gabrielpalassi/DontForget/docs/Relatório & Documentação.pdf

Experiência – Sistema de Sonar

Escola Politécnica da USP
Departamento de Engenharia de Computação e Sistemas Digitais PCS3645 – Laboratório Digital II

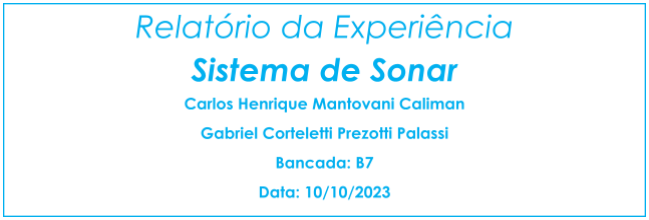
[picture p4: figure]

Turma 02 – Prof. Wilian França

### 1. Objetivos

Esta experiência tem por objetivo iniciar o desenvolvimento de um circuito que realiza a varredura e a detecção de objetos próximos com a utilização de um sensor ultrassônico de distância e de um servomotor, com saída serial para um dispositivo de apresentação. A implementação e testes do Sistema de Sonar serão desenvolvidas para a placa de desenvolvimento FPGA DE0-CV, usando a infraestrutura disponível na bancada do Laboratório Digital.

### 2. Descrição do Projeto

Sistemas digitais conhecidos como radar, lidar ou sonar podem ser caracterizados com um sistema que tem como função principal a detecção de objetos a distância. Esta detecção pode ser realizada através de ondas eletromagnéticas que são emitidas pelo radar, refletidas nos objetos distantes e recebidas por sensores. A detecção destes objetos permite a localização e a medida de sua distância. Sistemas veiculares autônomos em desenvolvimento por diversas empresas e grupos de pesquisa podem usar outros tipos de sistemas de detecção. Uma das alternativas é o lidar (light detection and ranging). Neste sistema, a distância a objetos é verificada com uso de um laser. Dependendo do sinal eletromagnético usado, um sistema de detecção de objetos pode ser nomeado de forma diferente. Por exemplo, no caso dos submarinos, usam-se ondas acústicas para propagação na água, e seu sistema é chamado sonar (sound navigation and ranging). Dependendo da frequência acústica usada temos sistemas infra sônicos (baixas frequências) ou sistemas ultrassônicos (altas frequências). Nesta experiência, usaremos o sensor ultrassônico de distância HC-SR04, que trabalha com pulsos ultrassônicos de 40KHz.

O projeto desta experiência visa desenvolver um circuito digital que permite rastrear objetos através da medida de distância aos objetos. A interface básica de sinais do circuito deve seguir os sinais apresentados na figura 1. O processo de varredura e medida de distância aos objetos é executado com auxílio de um atuador e de um sensor específico.

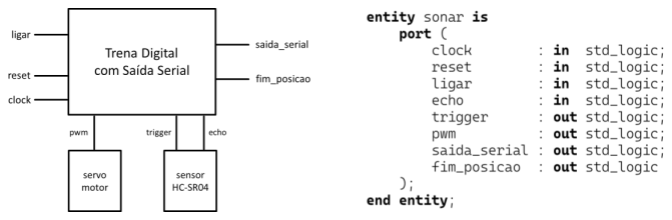
[picture p5: figure]

Figura 1 - Interface básica do sistema de Sonar

O atuador escolhido é um servomotor responsável por posicionar o sensor de distância para a varredura e localização de objetos. A montagem física destes componentes deve permitir uma variação angular dentro dos limites especificados para o servomotor. A figura 2 ilustra uma possível montagem física.

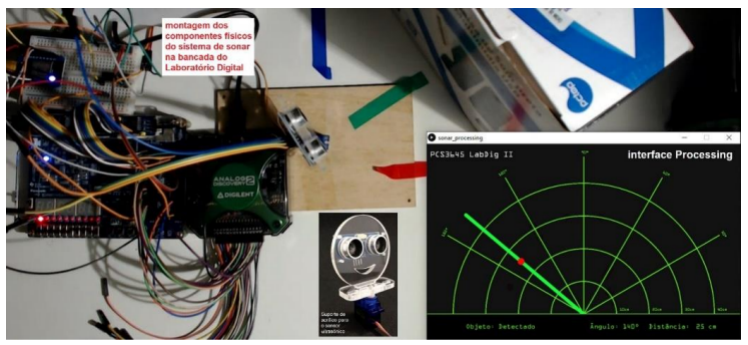
[picture p6: figure]

Figura 2 - Montagem do sistema de sonar na bancada do Laboratório Digital

A figura acima também apresenta os principais elementos do projeto e sua interação durante seu funcionamento. O sensor HC-SR04 é acoplado ao servomotor que permite sua rotação em relação ao seu eixo. A cada posição angular estabelecida, a distância ao objeto mais próximo deve ser medida. Em seguida, um bloco de informação composto por posição angular e distância deve ser enviado pela interface serial, que posteriormente será representado graficamente na tela do computador.

### 3. Atividades Pré-Laboratório

O funcionamento do sistema de sonar deve seguir a seguinte descrição:

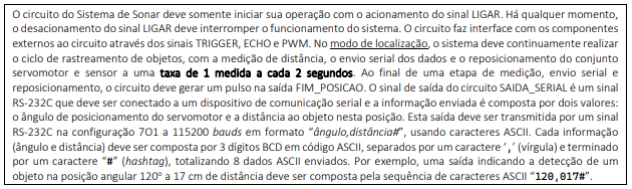
[picture p7: figure]

Figura 3 - Descrição do funcionamento do Sistema de Sonar

Inicialmente, foi executada a refatoração do código fonte dos circuitos projetados nas experiências passadas:

O circuito de controle do servomotor (controle_servo.vhd) foi modificado para gerar o sinal PWM de saída para 8 posições angulares com as seguintes larguras de pulso.

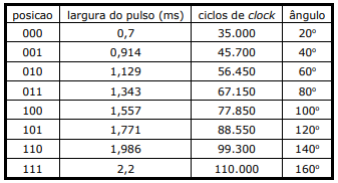
[picture p8: figure]

Figura 4 - Posições do servomotor

Os circuitos de transmissão serial assíncrona (tx_serial_7O1.vhd) e de recepção serial assíncrona (rx_serial_7O1.vhd) com o modo de transmissão 7O1, com dados de 7 bits, a uma taxa de 115200 bauds foram refatorados para serem usados como componentes internos.

A funcionalidade do circuito interno da interface com o sensor ultrassônico de distância HC-SR04 (interface_hcsr04.vhd) não precisou ser modificada para esta experiência.

A figura 5 apresenta um esboço do pseudocódigo do Sistema de Sonar.

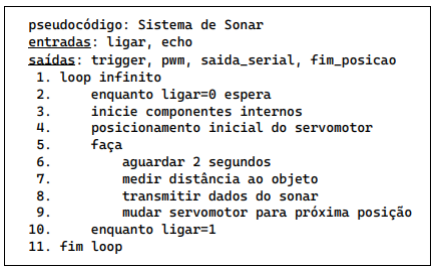
[picture p9: figure]

Figura 5 - Esboço do pseudocódigo do sistema de sonar

### 4. Planejamento da Aula Prática

O Sistema de Sonar opera quando o sinal "LIGAR" é acionado e é desativado ao desligar esse sinal. Ele se conecta a componentes externos usando os sinais "TRIGGER," "ECHO," e "PWM." Durante a localização, o sistema rastreia objetos, mede distâncias e envia dados em formato "ângulo,distância#" via RS-232C a 115200 bauds, usando caracteres ASCII. Cada conjunto de informações (ângulo e distância) tem três dígitos BCD em código ASCII, separados por vírgula e finalizados por um hashtag.

Desenvolveu-se o projeto do circuito do Sistema de Sonar, conforme especificação apresentada acima.

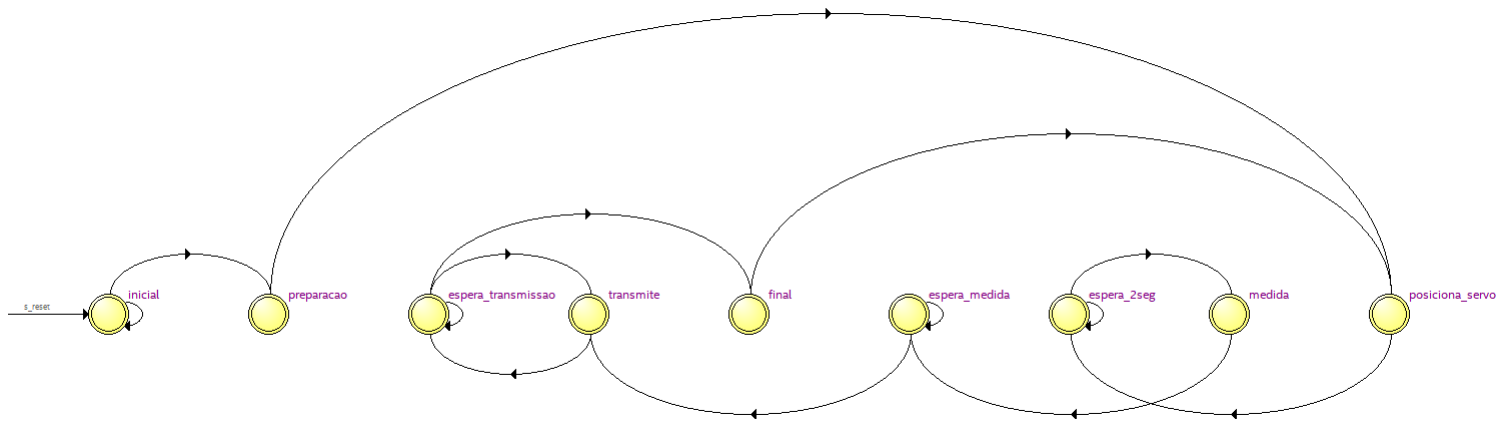
[picture p10: figure]

A figura acima exibe uma visualização da máquina de estados implementada, que é uma representação gráfica das diferentes etapas ou estados que o sistema pode assumir, juntamente com as transições entre esses estados, seguindo descrição supracitada.

Figura 6 - State Machine Viewer

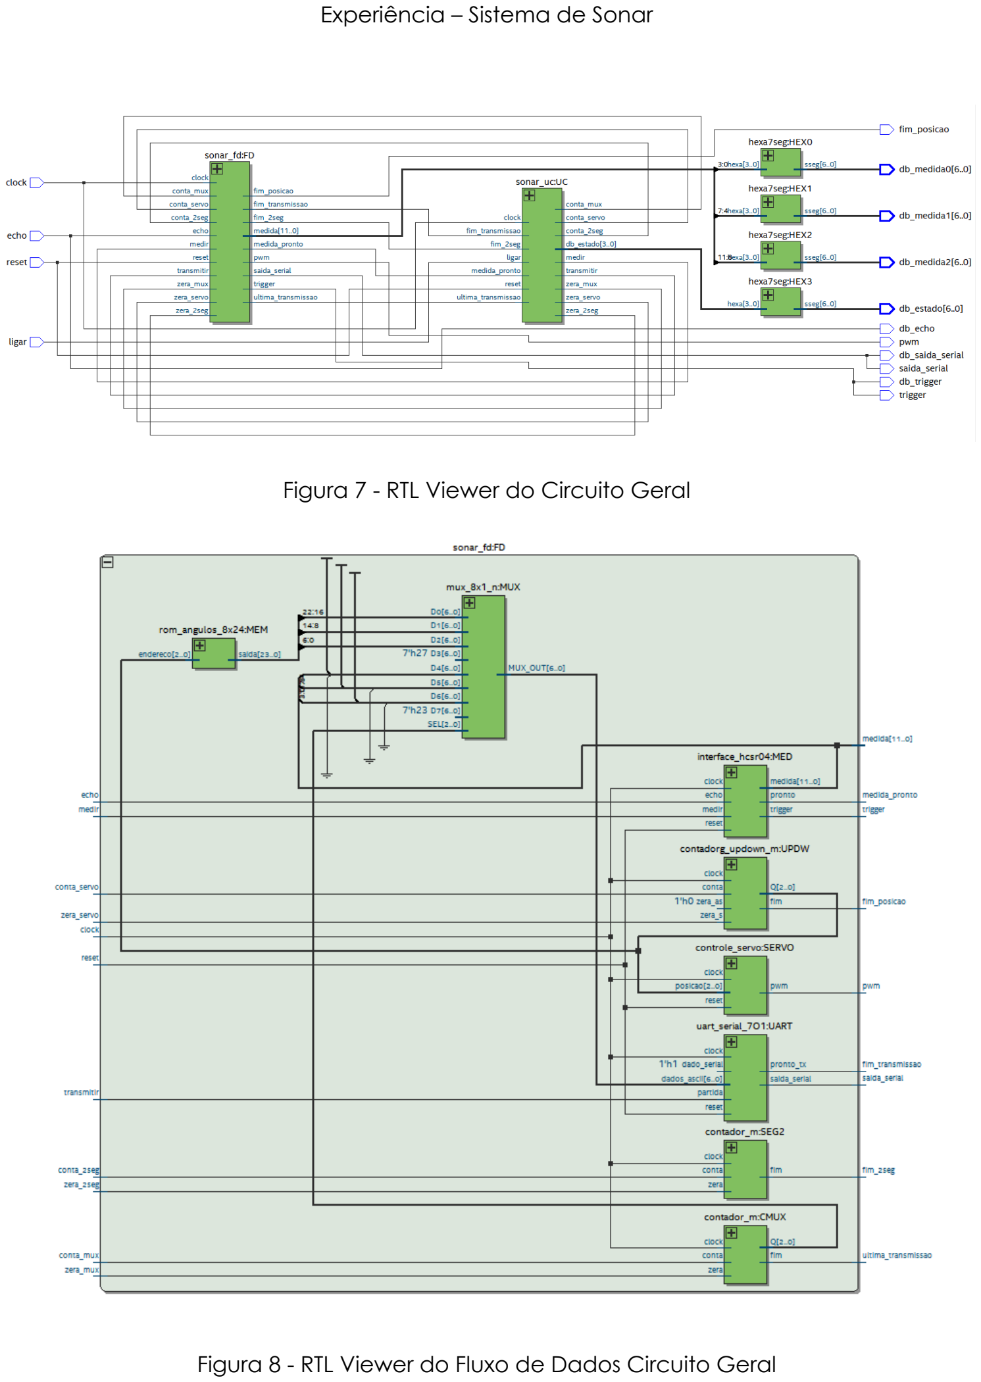
[picture p11: page 5]

Figura 7 - RTL Viewer do Circuito Geral

Figura 8 - RTL Viewer do Fluxo de Dados Circuito Geral

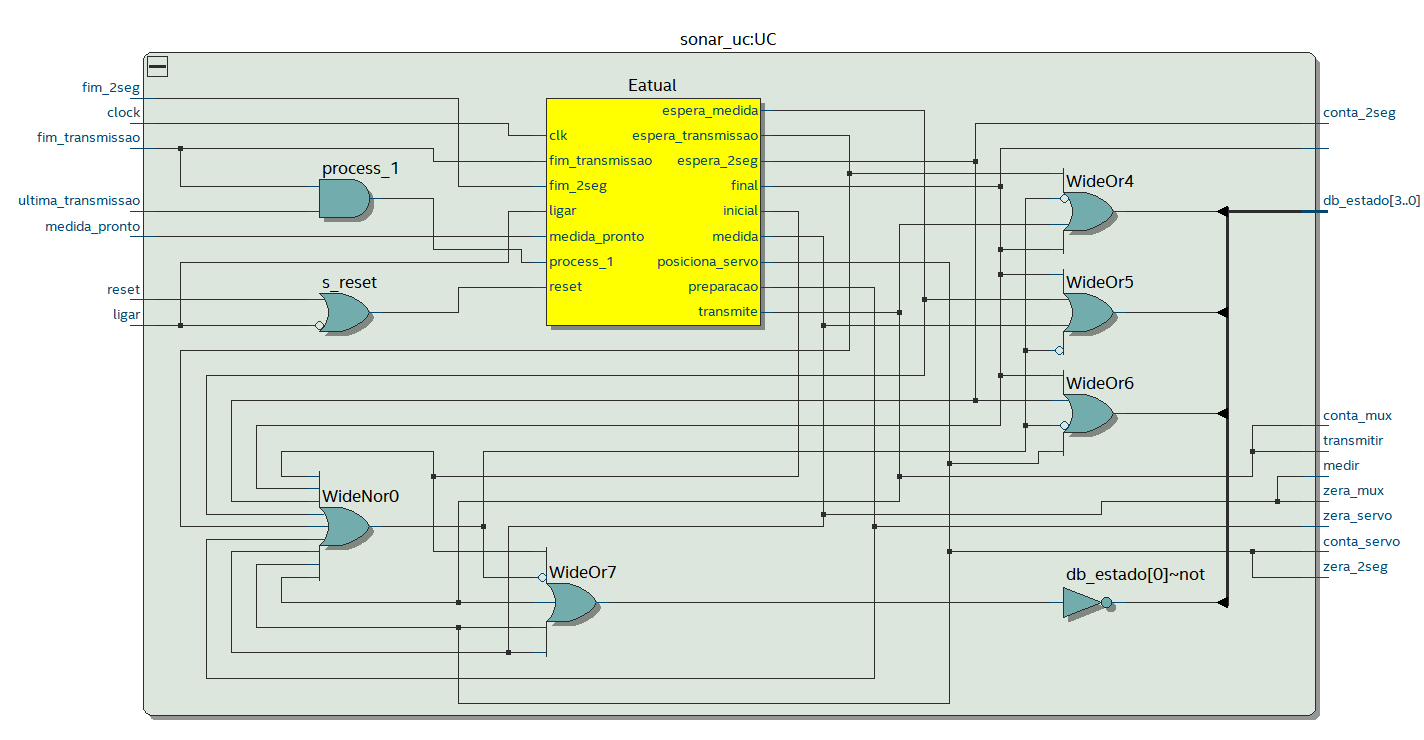
[picture p12: figure]

Figura 9 - RTL Viewer da Unidade de Controle do Circuito Geral

As figuras acima fornecem diferentes visualizações em nível RTL do circuito geral implementado descrito. O RTL Viewer é uma ferramenta que permite analisar o design do circuito em termos de registros e transferências de dados.

Para atestar o comportamento funcional do circuito desenvolvido utilizou-se do software ModelSim e do testbench fornecido:

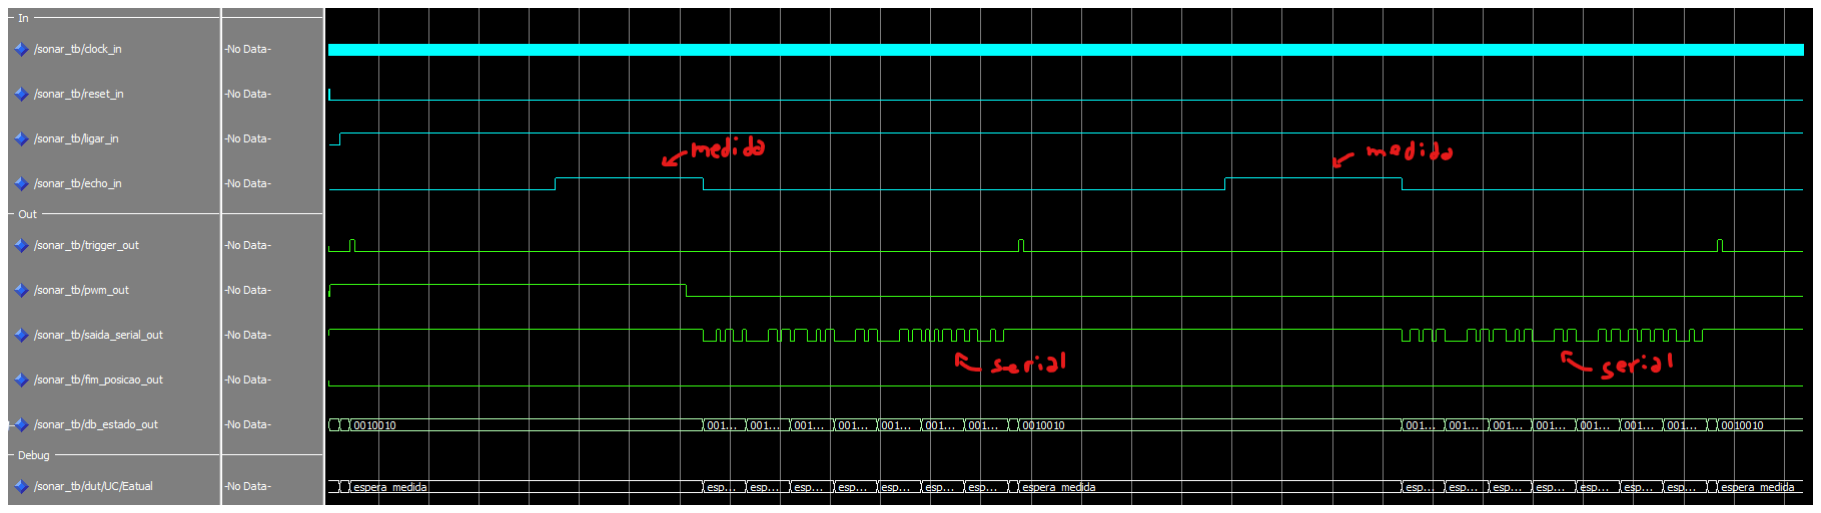
[picture p13: figure]

Figura 10 - Simulação ModelSim do testbench

Atestado o funcionamento teórico do circuito implementado, se montará o circuito conforme pinagem descrita abaixo e criou-se um plano de teste para a verificação do funcionamento prático quando em laboratório:

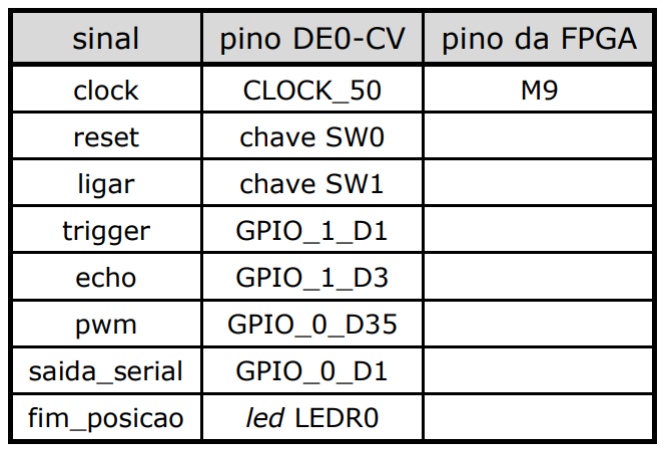
[picture p14: figure]

Figura 11 - Pinagem

Tabela 1 - Plano de Testes

Item de Teste | Procedimento | Resultado Esperado
Início e Parada do Sistema | Acionar e desativar o sinal "LIGAR" | Sistema inicia e para
Comunicação com Componentes Externos | Verificar sinais "TRIGGER," "ECHO," e "PWM" | Funcionamento correto e interação adequada
Saída Serial | Conectar "SAIDA_SERIAL" ao computador e verificar os dados | Dados transmitidos no formato correto em ASCII e valores corretos

### 5. Atividades Experimentais

Realizou-se em laboratório, a montagem do circuito, seguindo a verificação dos sinais conforme as experiências anteriores.

Conectou-se o trigger ao sensor supersônico e a resposta echo diretamente ao analog discovery, validando o sensor e obtendo-se a resposta apresentada abaixo.

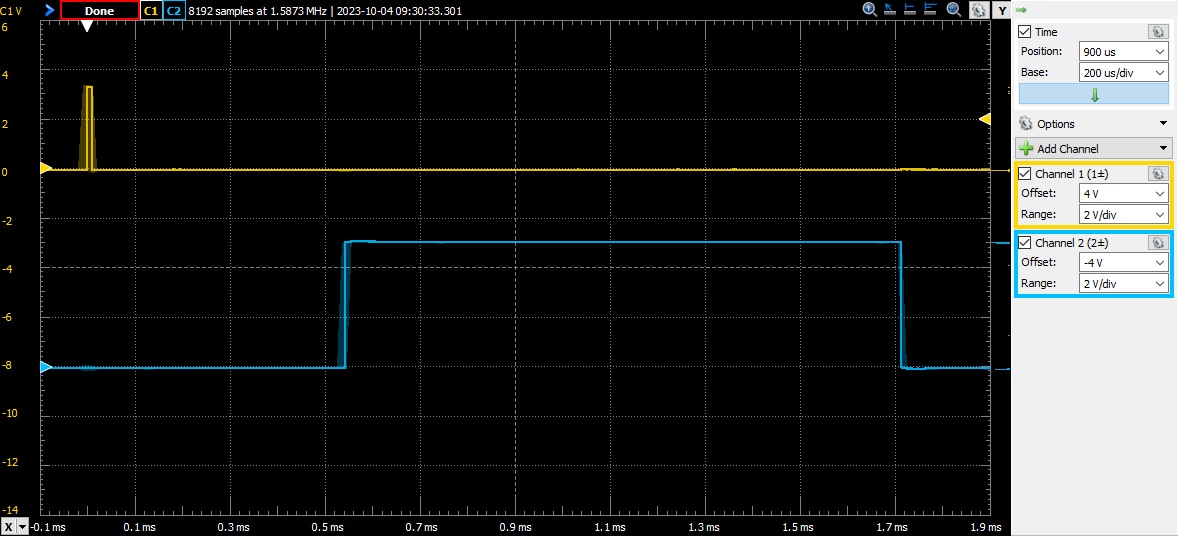
[picture p15: figure]

Figura 12 - Teste do echo ligado diretamente

Na figura, é possível notar o sinal de trigger enviado ao sensor, em amarelo, e a resposta echo em azul. Fica evidente também que o sinal gerado pela FPGA é de 3,3V, enquanto a resposta do sensor está em 5V.

Seguiu-se com a montagem, adicionando o conversor de tensão e, então, testou-se se a tensão do pulso recebido foi corretamente adaptada, o que se provou correto como mostrado.

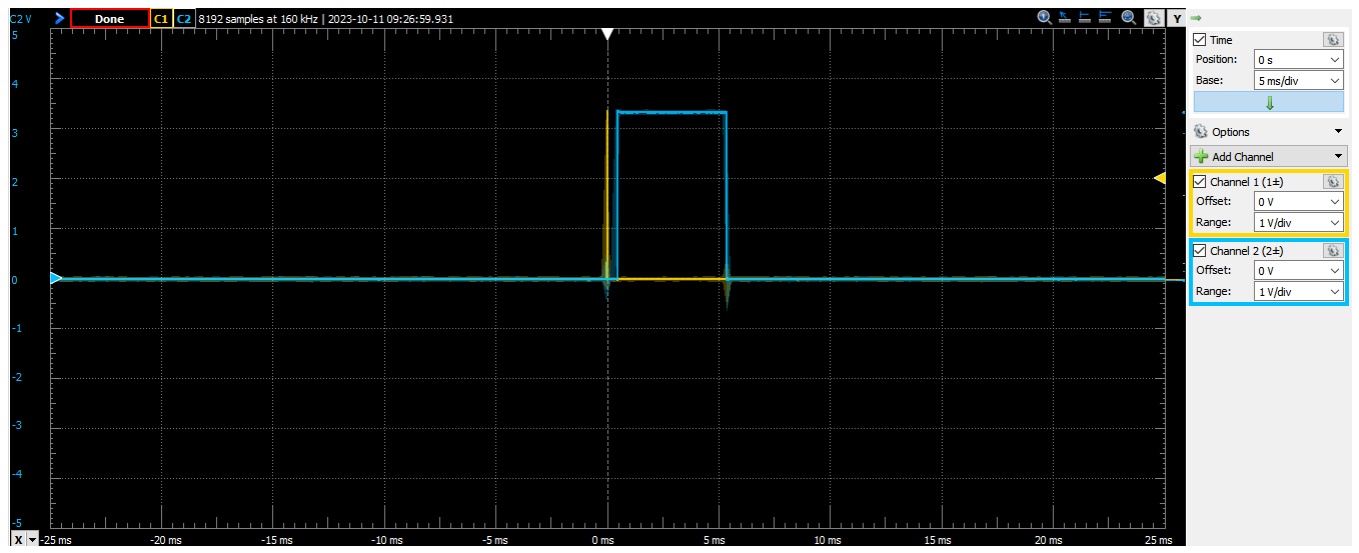
[picture p16: figure]

Figura 13 - Teste do echo convertido

Realizou-se, então, a depuração da saída serial com as ferramentas scope e protocol do WaveForms, conforme demonstram as figuras abaixo.

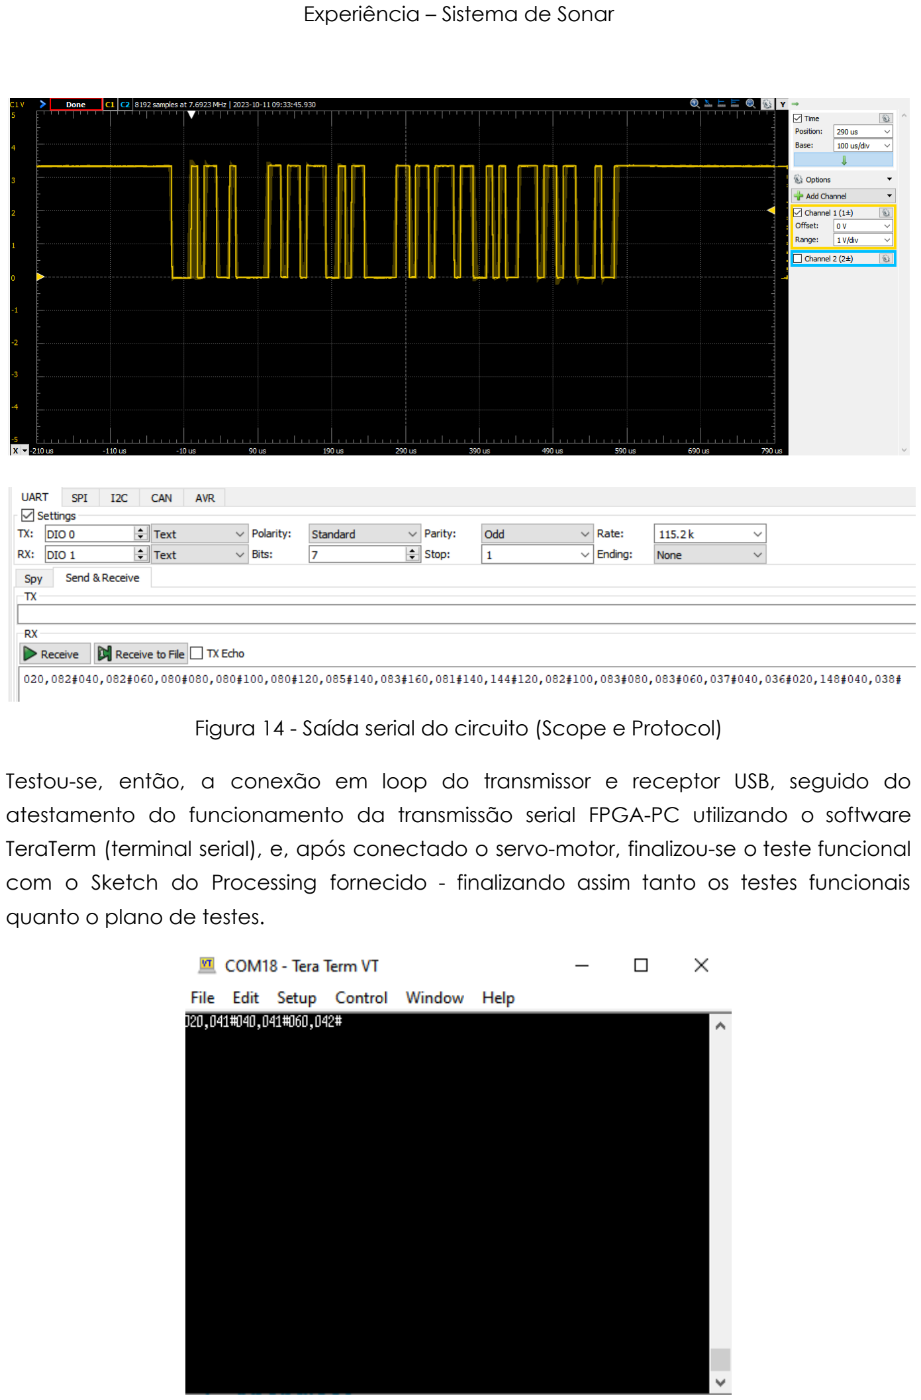
[picture p17: page 9]

Figura 14 - Saída serial do circuito (Scope e Protocol)

Testou-se, então, a conexão em loop do transmissor e receptor USB, seguido do atestamento do funcionamento da transmissão serial FPGA-PC utilizando o software TeraTerm (terminal serial), e, após conectado o servo-motor, finalizou-se o teste funcional com o Sketch do Processing fornecido - finalizando assim tanto os testes funcionais quanto o plano de testes.

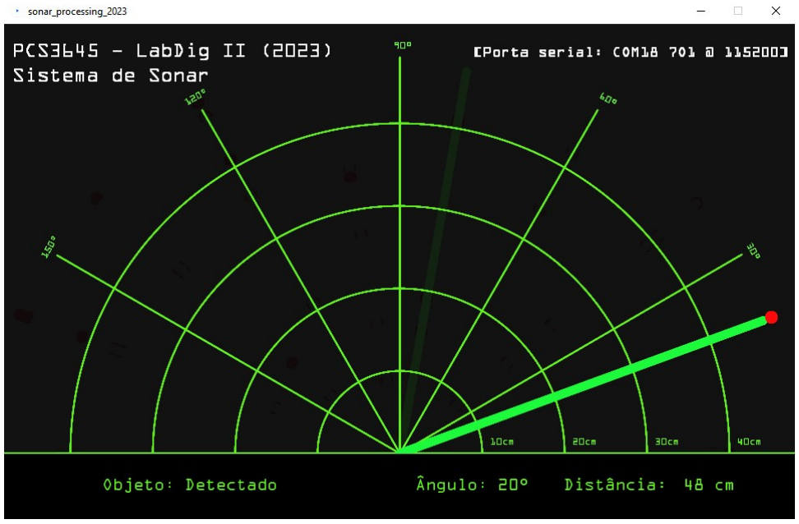
[picture p18: figure]

Figura 15 - TeraTerm e Processing
